BramRausch/PiPod/Case/Assembly/IMG_20180805_153556.jpg

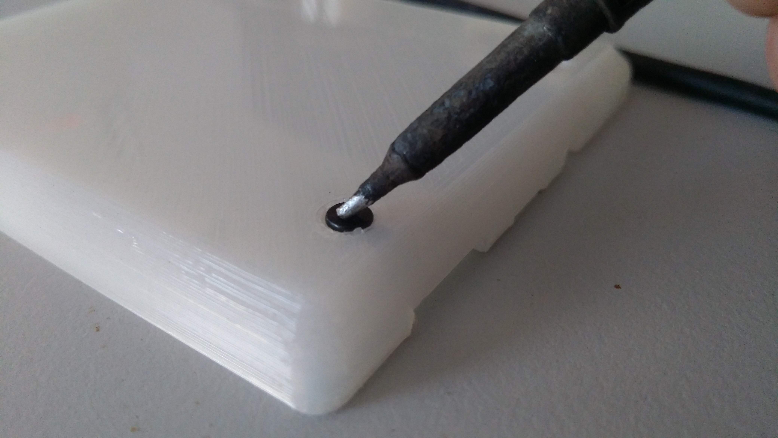
Case/Assembly/IMG_20180805_153556.jpg
