BramRausch/PiPod/Hardware/Assembly/Bottom V2.JPG

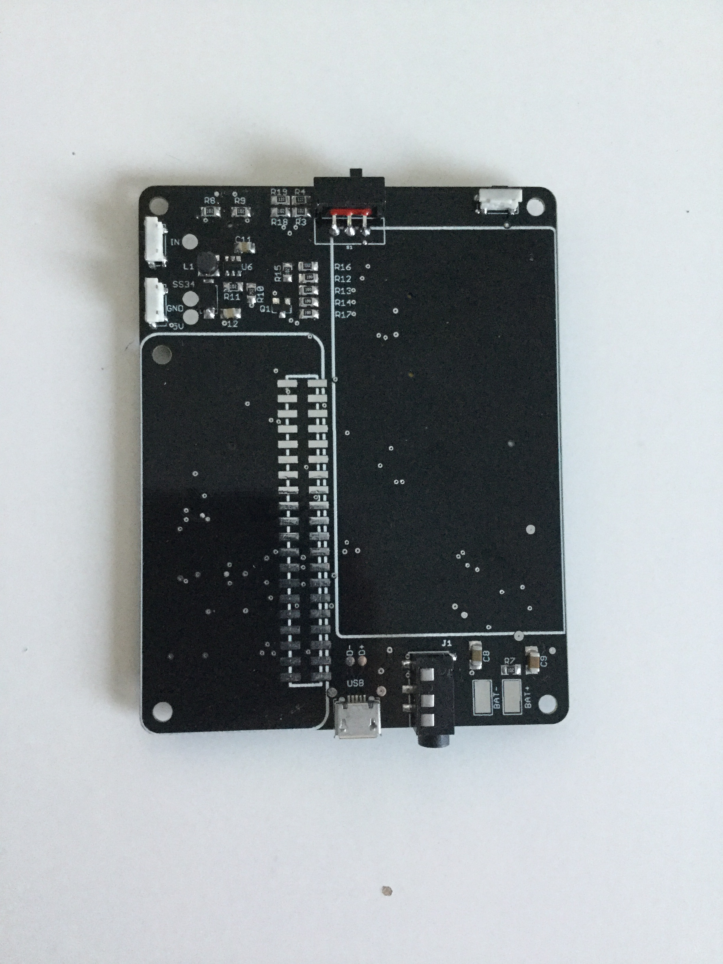
Hardware/Assembly/Bottom V2.JPG
