BramRausch/PiPod/Hardware/Assembly/Part list.xlsx

Name | Value | Package | Quantity
R12, R13, R14, R17 | 10R | 0805 | 4
R7 | 100R | 0805 | 1
R1, R2 | 470R | 0805 | 2
R3, R5, R8, R9, R11, R15, R18 | 1k | 0805 | 7
R4, R6, R19 | 1k2 | 0805 | 3
R10 | 7k5 | 0805 | 1
R16 | 10k | 0805 | 1
RN1 | 10k | 0603-ARC | 1
C13, C14 | 2.2nF | 0805 | 2
C1, C4, C5, C6, C16 | 0.1uF | 0805 | 5
C8, C10 | 0.1uF | 1206 | 2
C7 | 1uF | 0805 | 1
C2, C15 | 2.2uF | 0805 | 2
C3 | 10uF | 0805 | 1
C9 | 10uF | 1206 | 1
C11, C12 | 22uF | 0805 | 2
FB1 | 2500 | 0603 | 1
Q1 | 2N2222 | SOT23 | 1
U1 | DW01 |  | 1
U2 | 8205A |  | 1
U3 | TP4056 |  | 1
U4 | ADS1115 |  | 1
U5 | PCM5102 |  | 1
U6 | MT3608 |  | 1
SS34 | SS34 |  | 1
L1 | CD32 |  | 1
D1, D2 | LED | 0805 | 2
DISP1 |  | TM022HDH26 | 1
USB |  | FCI-10103594-0001LF | 1
J1 |  | PRT-12639 | 1
J2 |  | 2x20 P40 2.54mm SMT Pin Header | 1
S1 |  | EG1218 | 1
I_CENTER, I_LEFT, I_RIGHT, I_UP, I_DOWN |  | TL3342 | 5
I_SLEEP, I_VOL_DOWN, I_VOL_UP |  | TL3330 | 3
 |  |  | 61
