BramRausch/PiPod/Case/Bottom.stl

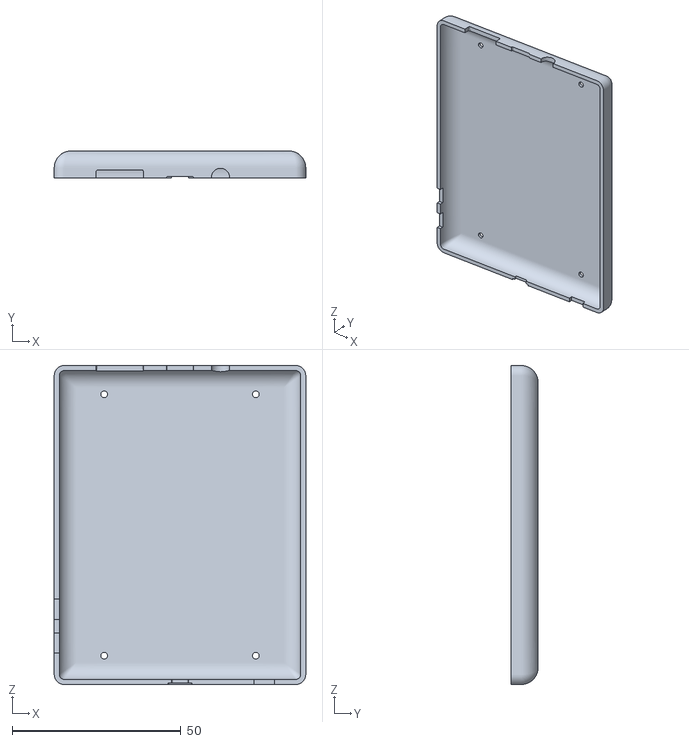
[picture p3: CAD file, 2018-08-07]
Case/Bottom.stl
74.6 x 8.05 x 94.6
