BramRausch/PiPod/Case/Top.stl

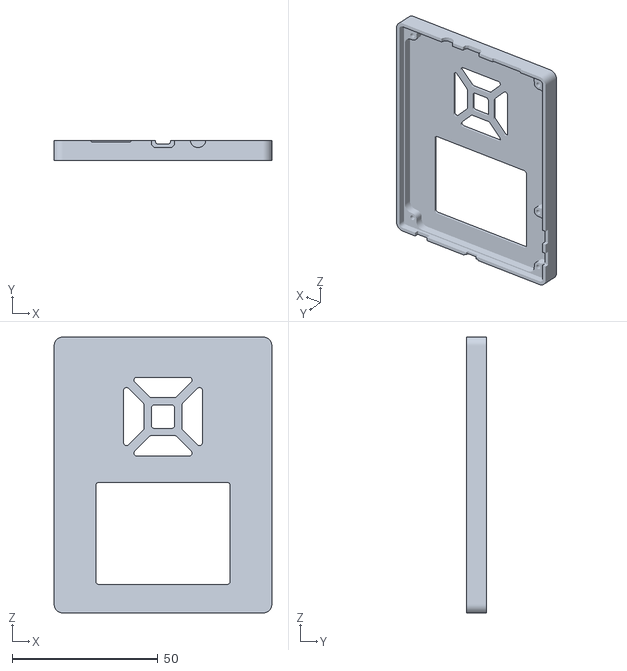
[picture p4: CAD file, 2018-08-07]
Case/Top.stl
74.6 x 7.00 x 94.6
