BramRausch/PiPod/Case/Frame.stl

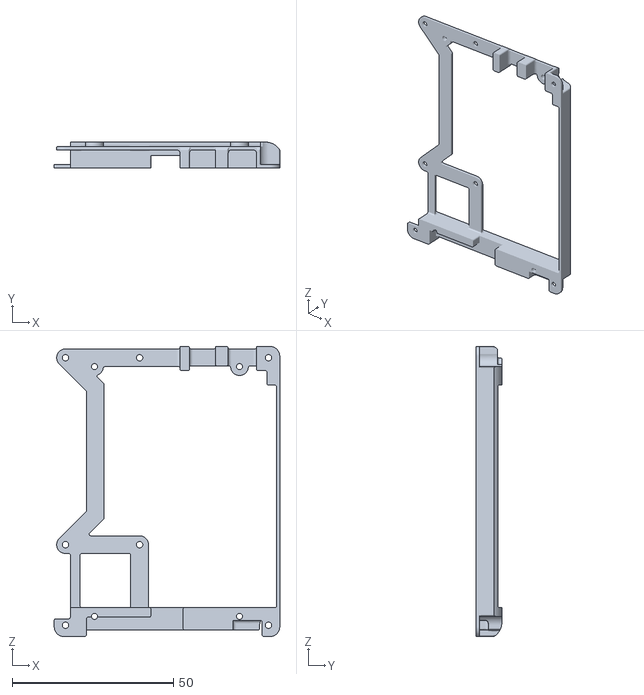
[picture p5: CAD file, 2018-08-07]
Case/Frame.stl
70.0 x 8.00 x 90.0
