BramRausch/PiPod/Case/RPi spacer.stl

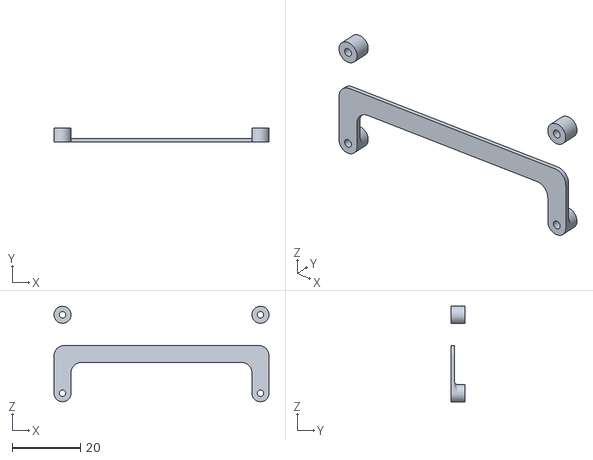
[picture p6: CAD file, 2018-08-07]
Case/RPi spacer.stl
63.0 x 4.00 x 28.0
