BramRausch/PiPod/Case/Buttons (navigation).stl

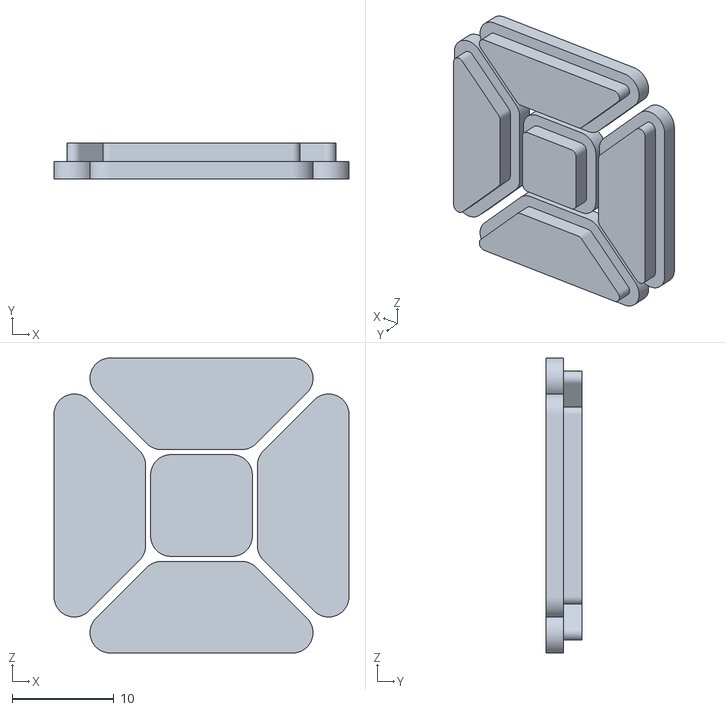
[picture p7: CAD file, 2018-08-07]
Case/Buttons (navigation).stl
29.0 x 3.50 x 29.0
