BramRausch/PiPod/Case/Ring.stl

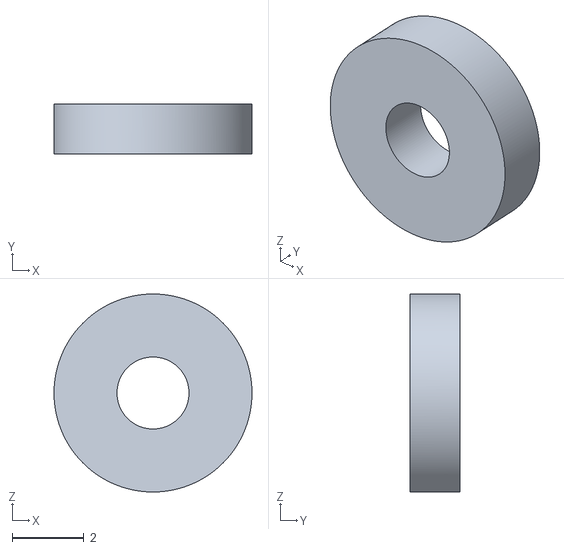
[picture p8: CAD file, 2018-08-07]
Case/Ring.stl
5.50 x 1.40 x 5.50
