BramRausch/PiPod/Case/Button (side).stl

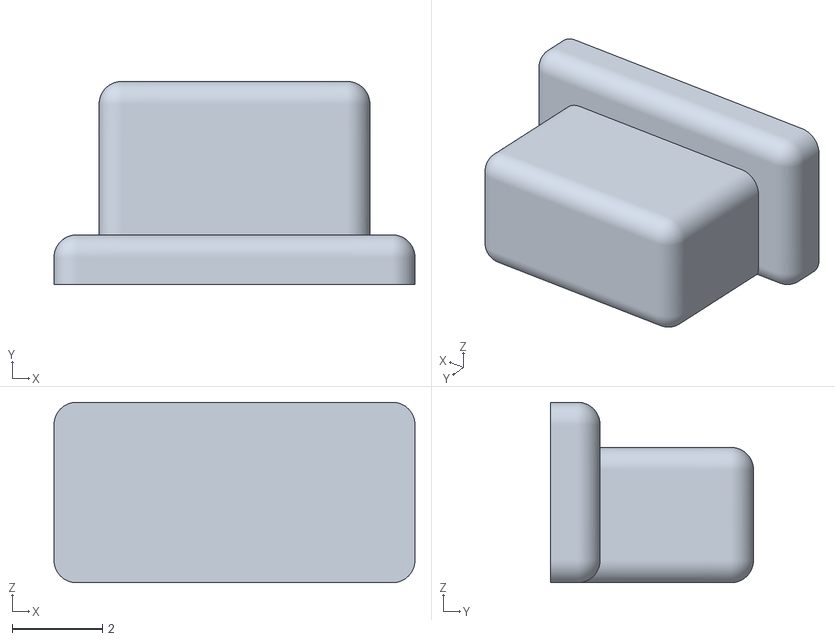
[picture p9: CAD file, 2018-08-07]
Case/Button (side).stl
8.00 x 4.50 x 4.00
