BramRausch/PiPod/Case/Assembly/Step 1 (ISO).png

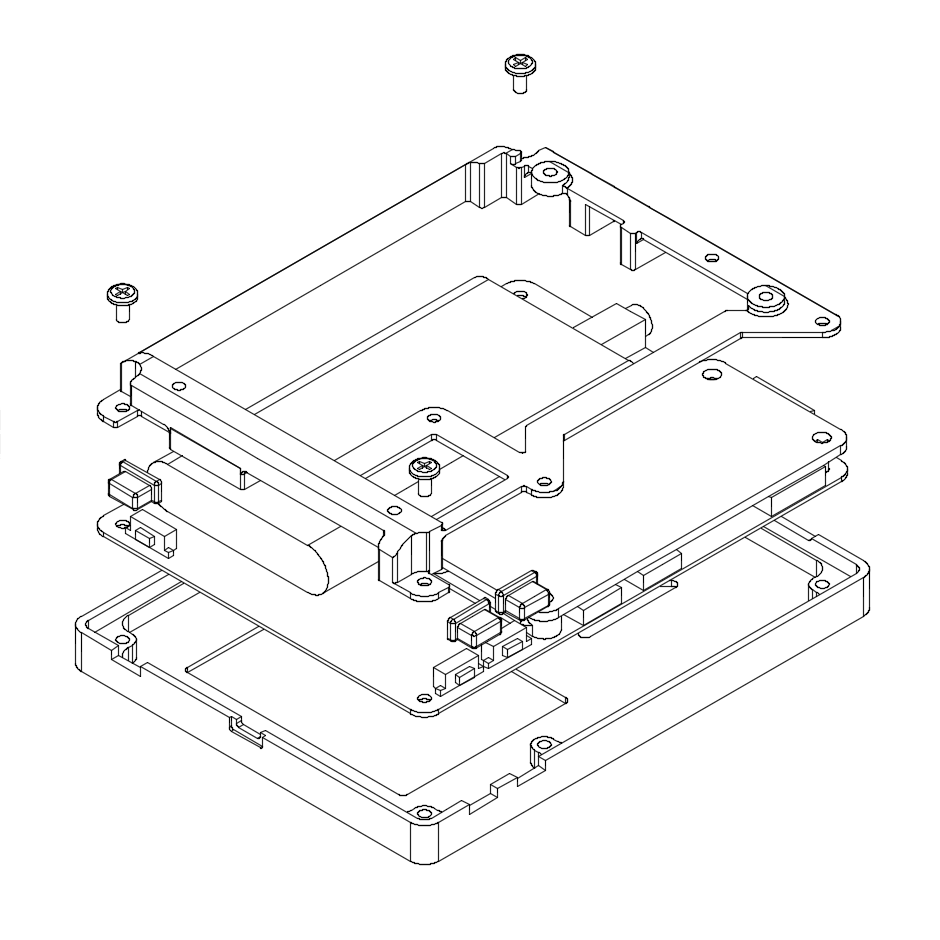
Case/Assembly/Step 1 (ISO).png
