BramRausch/PiPod/Case/Assembly/Step 1.png

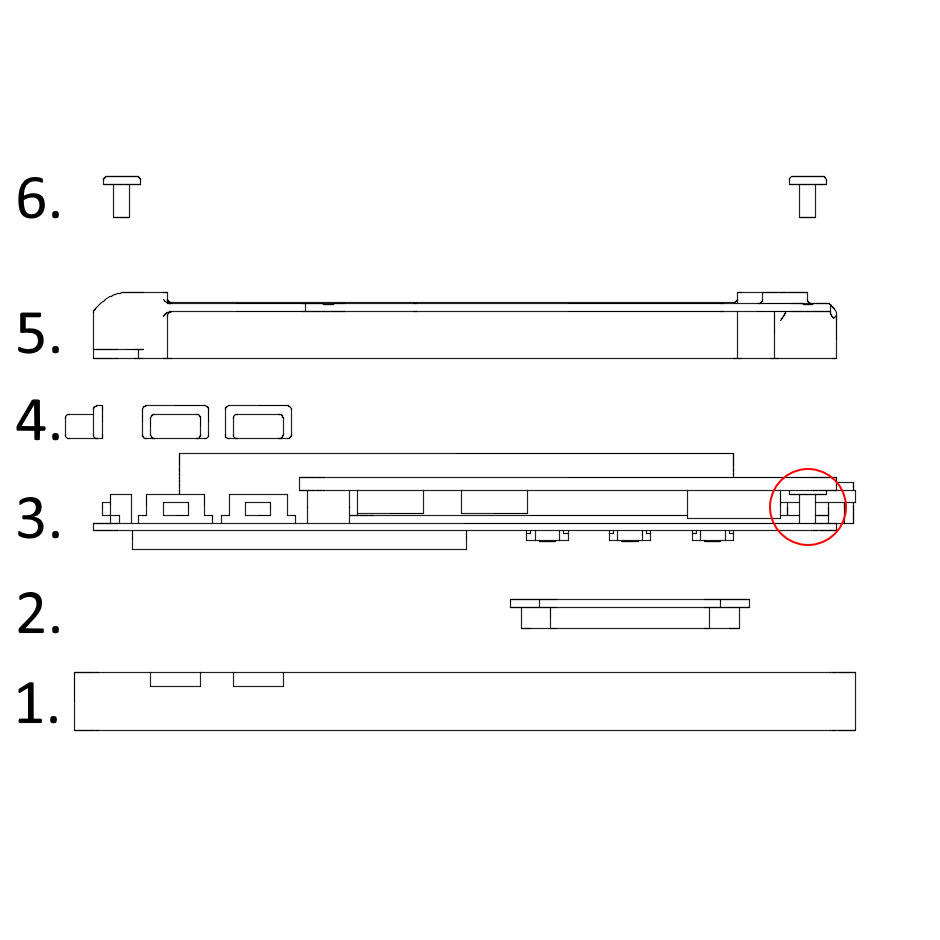
Case/Assembly/Step 1.png
