BramRausch/PiPod/Case/Assembly/Step 2 (Coloured).png

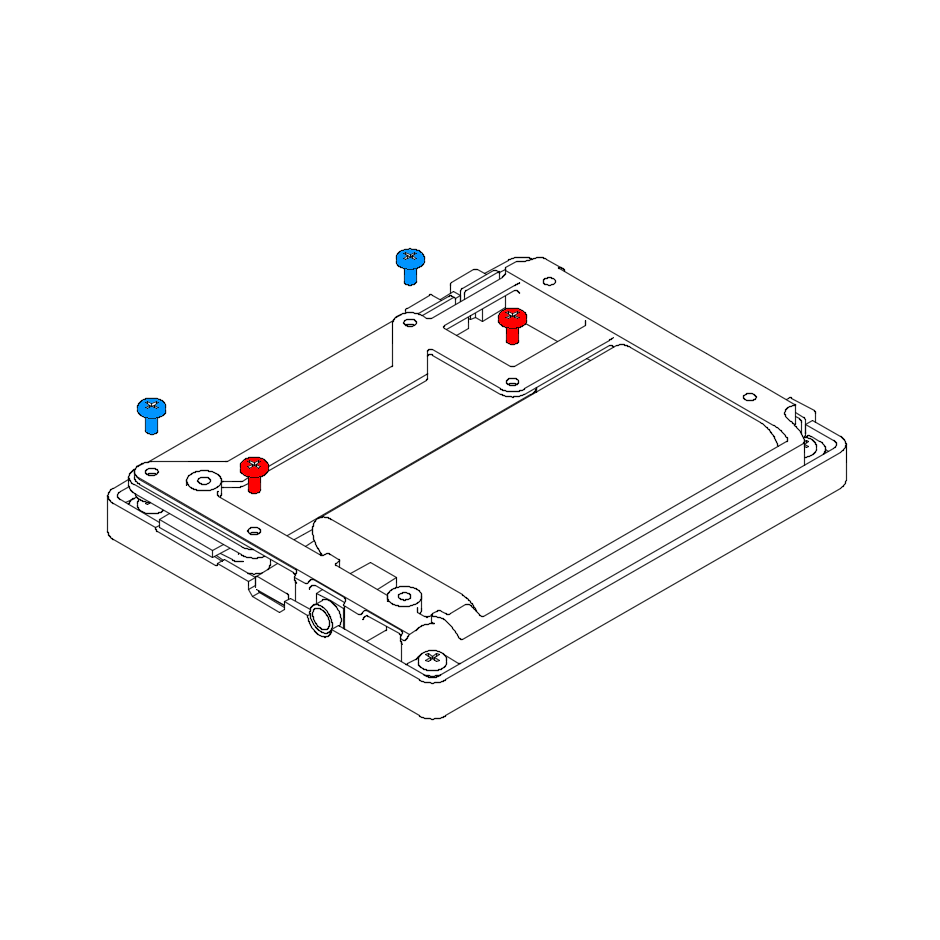
Case/Assembly/Step 2 (Coloured).png
