BramRausch/PiPod/Case/Assembly/Step 3.png

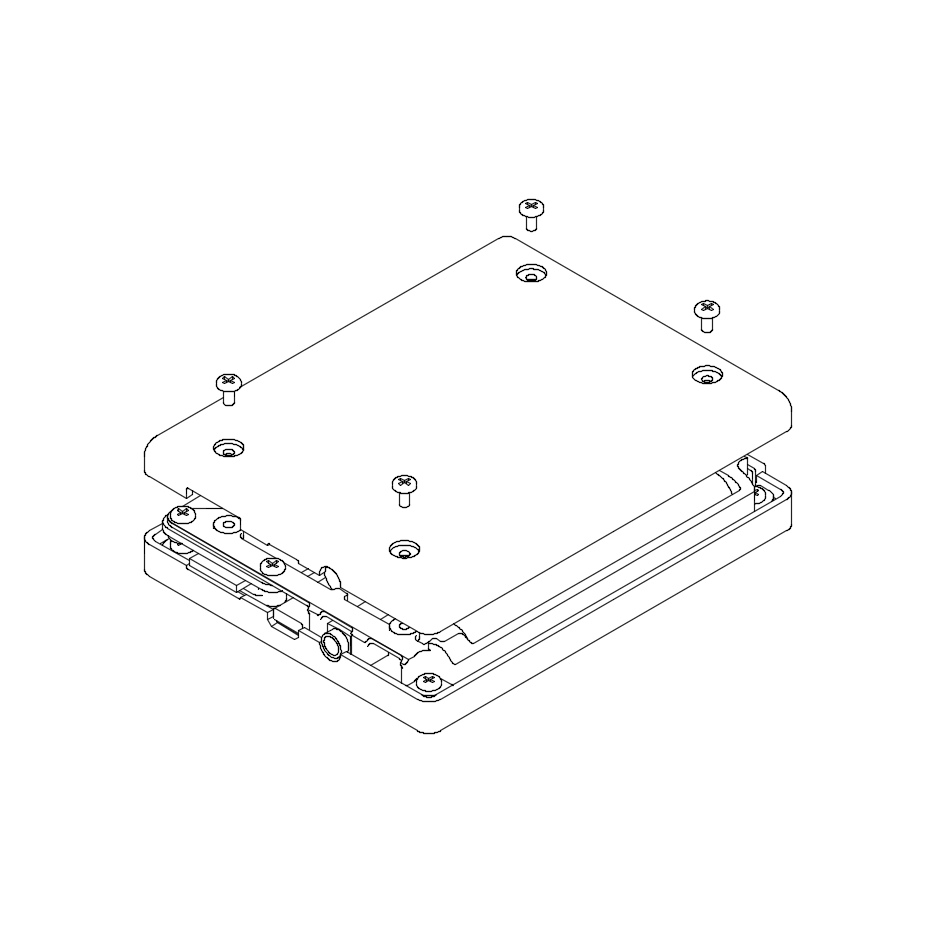
Case/Assembly/Step 3.png
