BramRausch/PiPod/Hardware/Assembly/Bottom V2.png

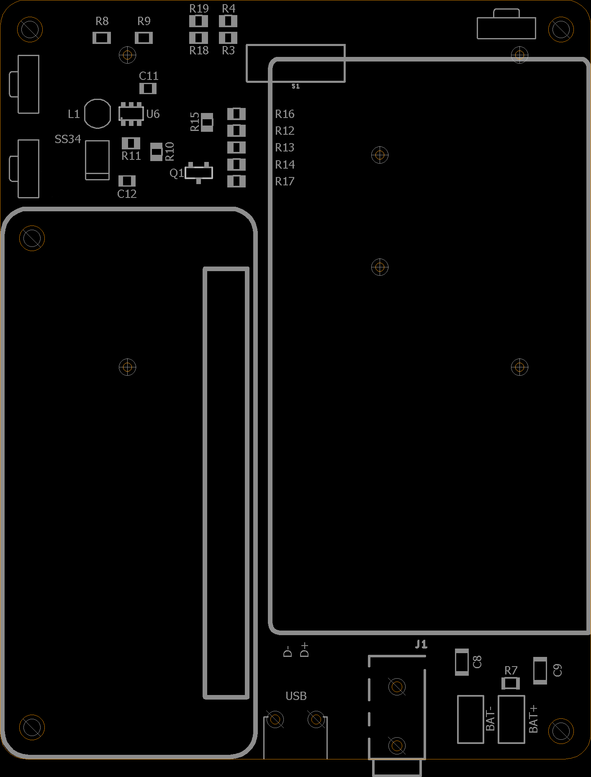
Hardware/Assembly/Bottom V2.png
