BramRausch/PiPod/Hardware/Assembly/Top V2.JPG

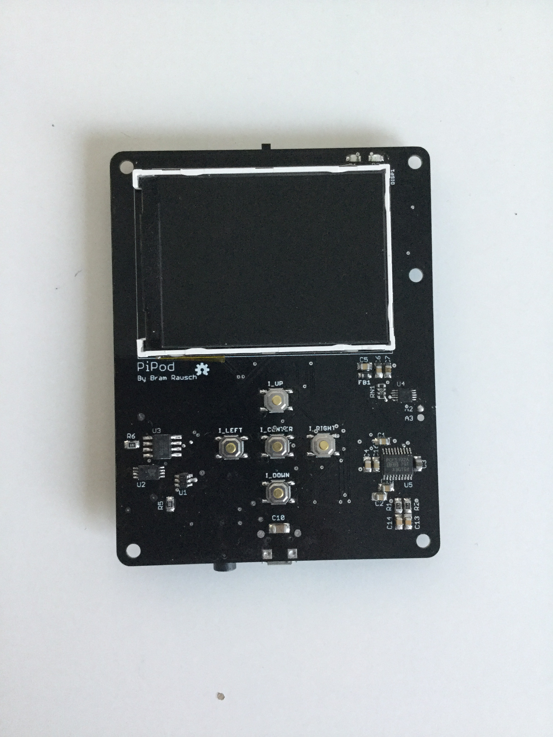
Hardware/Assembly/Top V2.JPG
