BramRausch/PiPod/Hardware/Assembly/Top V2.png

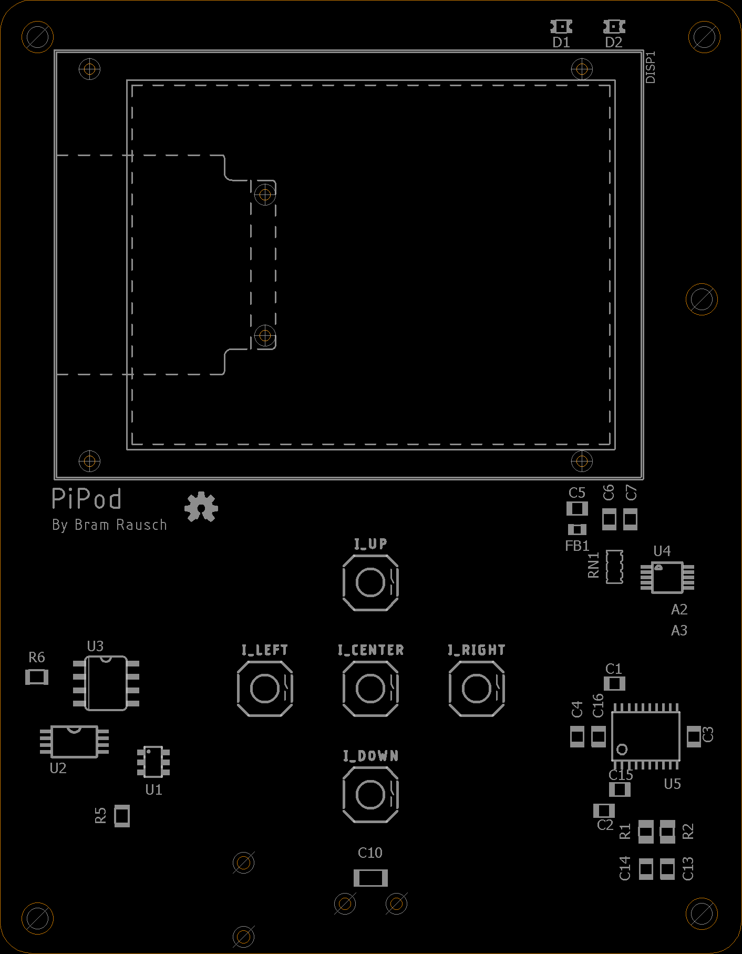
Hardware/Assembly/Top V2.png
