BramRausch/PiPod/(threads)

Thread 1 (2018-08-30):

Awesome project

gearhead, 2018-08-30:
Will be modifying the eagle files and building a version for myself: switching to a PCM5122, add a 48k and 44.1 clock for the PCM5122, add a 3v3 analog supply and add an attiny82 for soft power down capability. I'll provide them if you want to make a V3 version. Looks like there is plenty of room on the PCB. Also, I will be putting RuneAudio on it. Send me a message if you want the eagle files.

Worldgate, 2021-12-02:
Wouldn't happen to know where i can pick up the preassembled board for the v3?  This thing is perfect for an audiobook player i want to make.

ewaca, 2023-06-23:
@Worldgate you can buy assembled board here : https://www.pcbway.com/project/shareproject/PiPod___Raspberry_pi_Zero_portable_music_player.html

Fruity-Grebbles, 2023-06-23:
@gearhead I would appreciate a fork with your modifications

gearhead, 2023-06-24:
Unfortunately, I never finished it. I have a schematic in Eagle, but never finished routing the board. I lost interest after I bought a used iPod Video and put Rockbox on it. I would need to look for the eagle files. let me know if there is still interest and I will see if I can find it.

Thread 2 (2019-10-05):

SSH

thecomfychair2, 2019-10-05:
First up, love this project! My ipod nano finally gave up the ghost and I can't find anything off the shelf to replace it, so this is perfect!
I have flashed your latest image (Google drive link from the Hackaday page) onto my RaPi Zero, but now I can't seem to ssh to it. Does this image still allow for ssh?
I have tried doing the recommended mods to the Boot text files, and creating a file named 'ssh' in the boot directory, but cannot get a rise out of it.
Cheers in advance!

BramRausch, 2019-10-05:
Hey, the latest image doesn't have SSH enabled, and all networking services are disabled to start at the boot process because this isn't necessary for normal function, and speeds up the boot time by 30 - 60 seconds.

I enabled a serial driver instead of the USB ethernet gadget this makes your computer recognize the RPi as a serial device.

you can use a serial console to log in to the RPi using the following information:
Baudrate: 115200
Username: pi
Password: raspberry
The serial port can be found using device-manager.

If you want to use the Wifi functionality you'ill have to enable all network-related services in the system.d configuration.

thecomfychair2, 2019-10-06:
Perfect, that worked! Thank you very much for your help, and quick response!

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

Closed 2019-10-06.

Thread 3 (2023-07-18):

CD32 component résistance value ?

ewaca, 2023-07-18:
@BramRausch This project is amazing !
I'm trying to make this MP3 player, but i wonder wich value of resistance we need for the L1 part (CD32) ?

I tried to check it on your assembled PCB image, but its quality does not allow me to read correctly. It seems to bo write "10" on it.
can you confirm it ?

thank you

JWMTech, 2024-05-02:
I was wondering this myself.

ewaca, 2024-05-04:
it's a 47uh inductance value. I have bought this one and it works fine.
https://www.vs-elec.fr/inductance-cms/8501-inductances-de-puissance-cms-47uh-cd32-smd-353020mm-4uh7-3665662078049.html

But the way it manage the mp3 library is not great. I'm working on a mp3 player projet based on ESP32.

Thread 4 (2023-10-17):

PCB boards

coacharnold1, 2023-10-17:
Hi Bram

    a super cool project.  I'm sorry I missed it when it was new.  I've wanted to do this for  long time.   Can you tell me, are there any PCBs still around to be had, cases?   I'd like to buid one of these.

Thanks

Tim Arnold

JWMTech, 2024-05-02:
I am actively building some on PCB way. If you want one when they come in, I could send you one for a cheap price. They won't be complete, you'll still have to assemble the components on the PCB itself.
