BramRausch/PiPod/Hardware/PiPod Rev2 Schematic.pdf

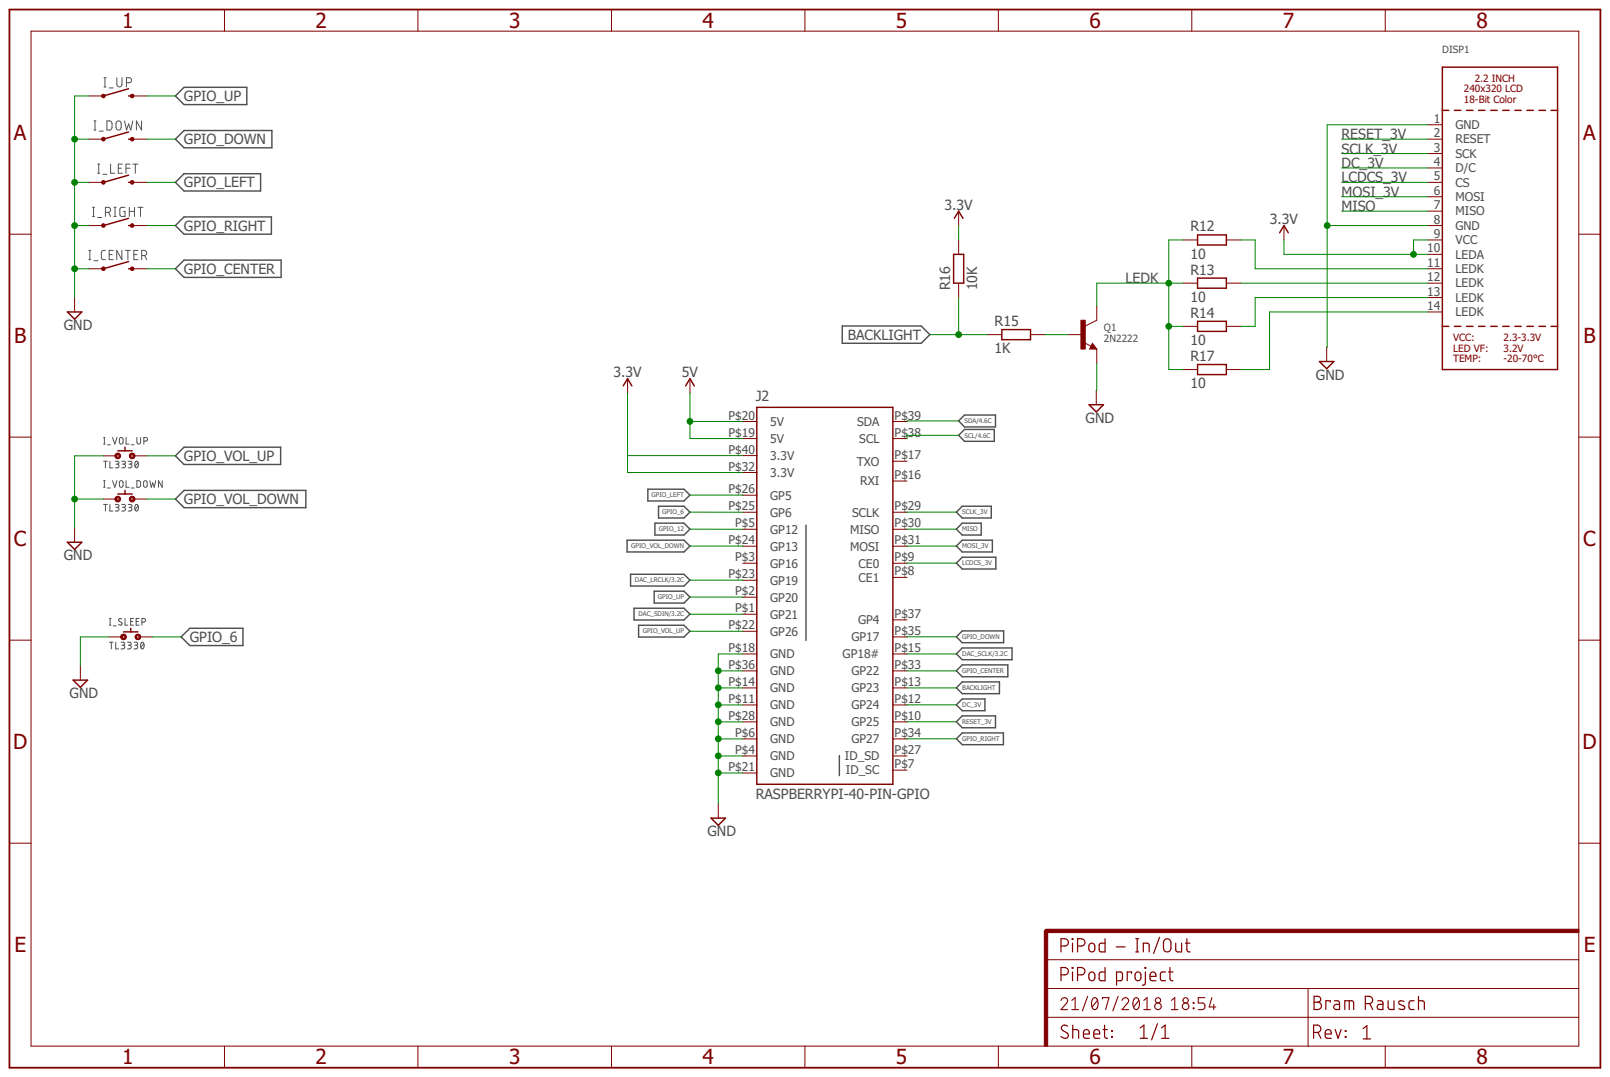
[picture p17: page 1]

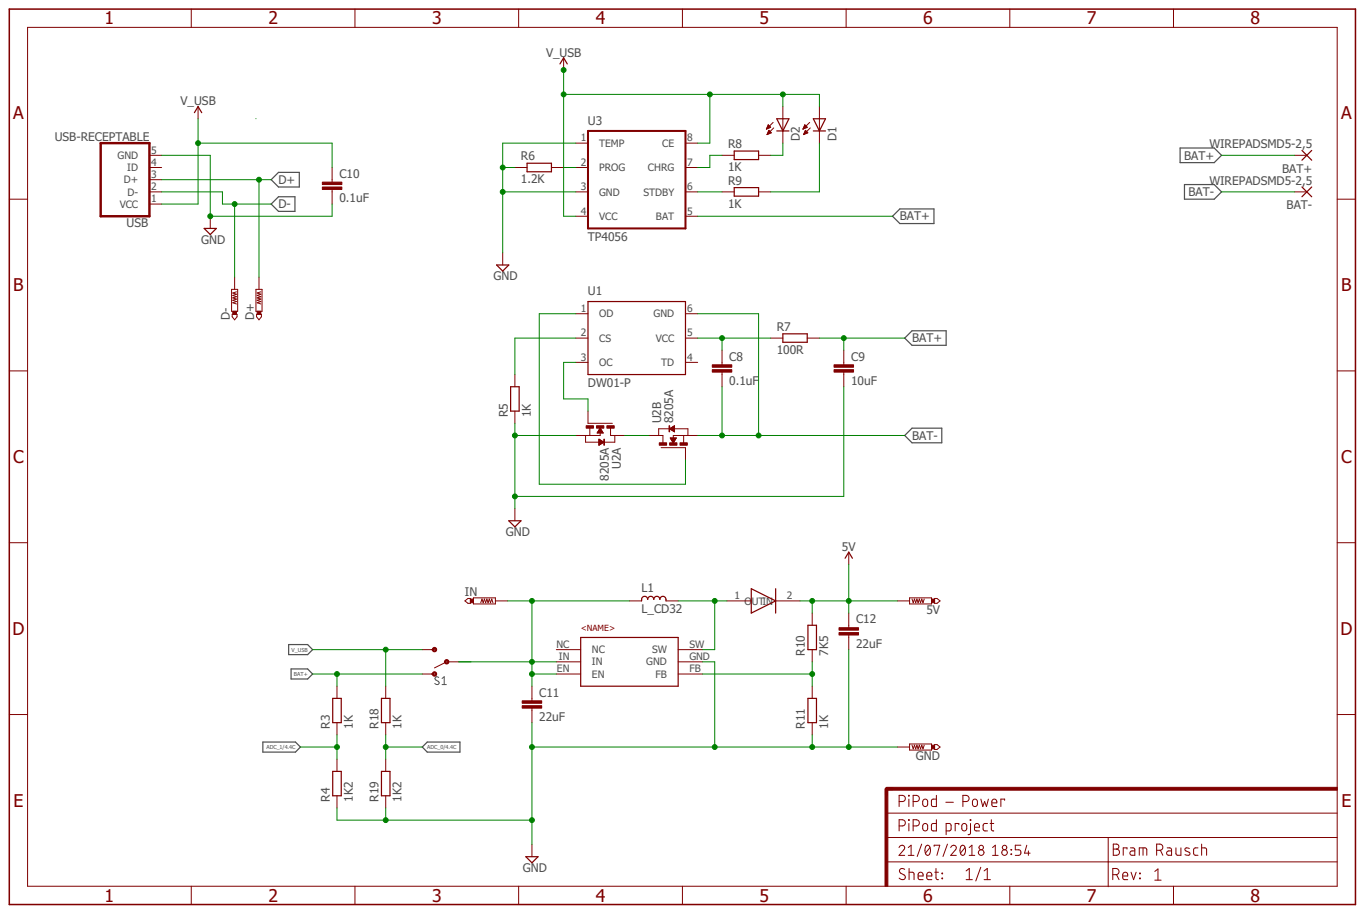
[picture p18: page 2]

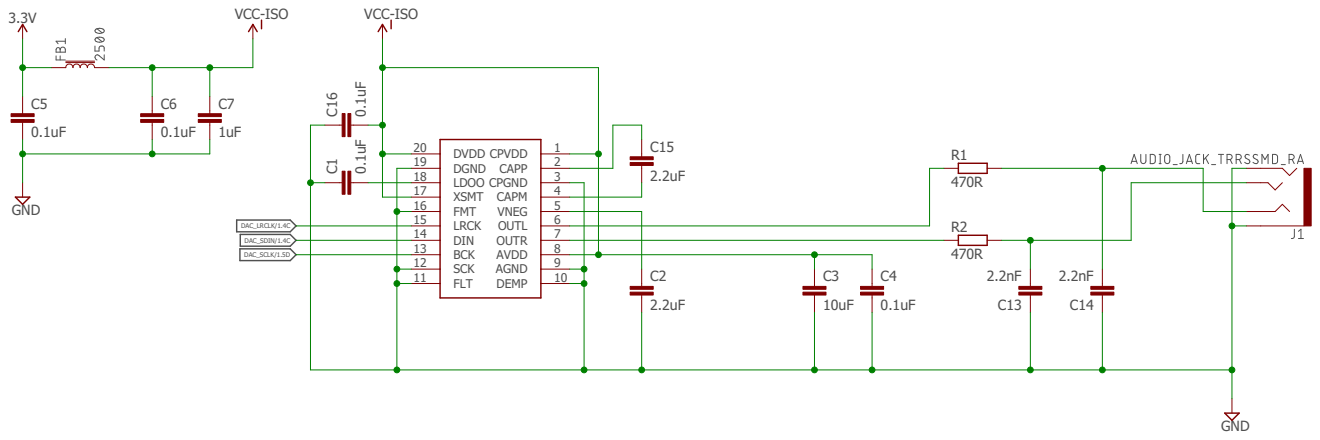
[picture p19: page 3]

17 | 4 VNEG
16 | 5

13 | 8 AGND
12 | 9 DEMP

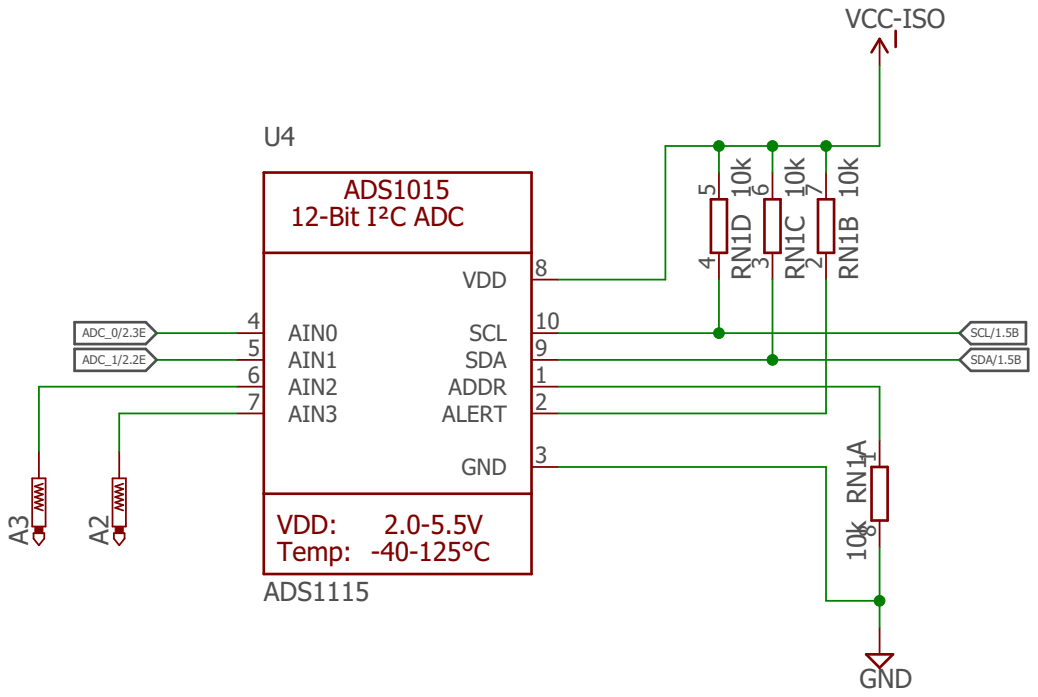
[picture p20: page 4]

10k 10k 10k 10k ADS1115 GND VCC-ISO RN1A1 8 RN1B 2 7 RN1C 3 6 RN1D 4 5 ADDR 1 AIN0 4 AIN1 5 AIN2 6 AIN3 7 ALERT 2 GND 3 SCL 10 SDA 9 VDD 8 U4 A2A3 SCL/1.5B SDA/1.5B ADC_0/2.3E ADC_1/2.2E ABCDE 1 2 3 4 5 6 7 8 ABCDE 1 2 3 4 5 6 7 8 ADS1015 12-Bit I²C ADC VDD: 2.0-5.5V Temp: -40-125°C
