BramRausch/PiPod/Hardware/PiPod Rev3.brd

## EAGLE design Hardware/PiPod Rev3.brd (2019-10-05)

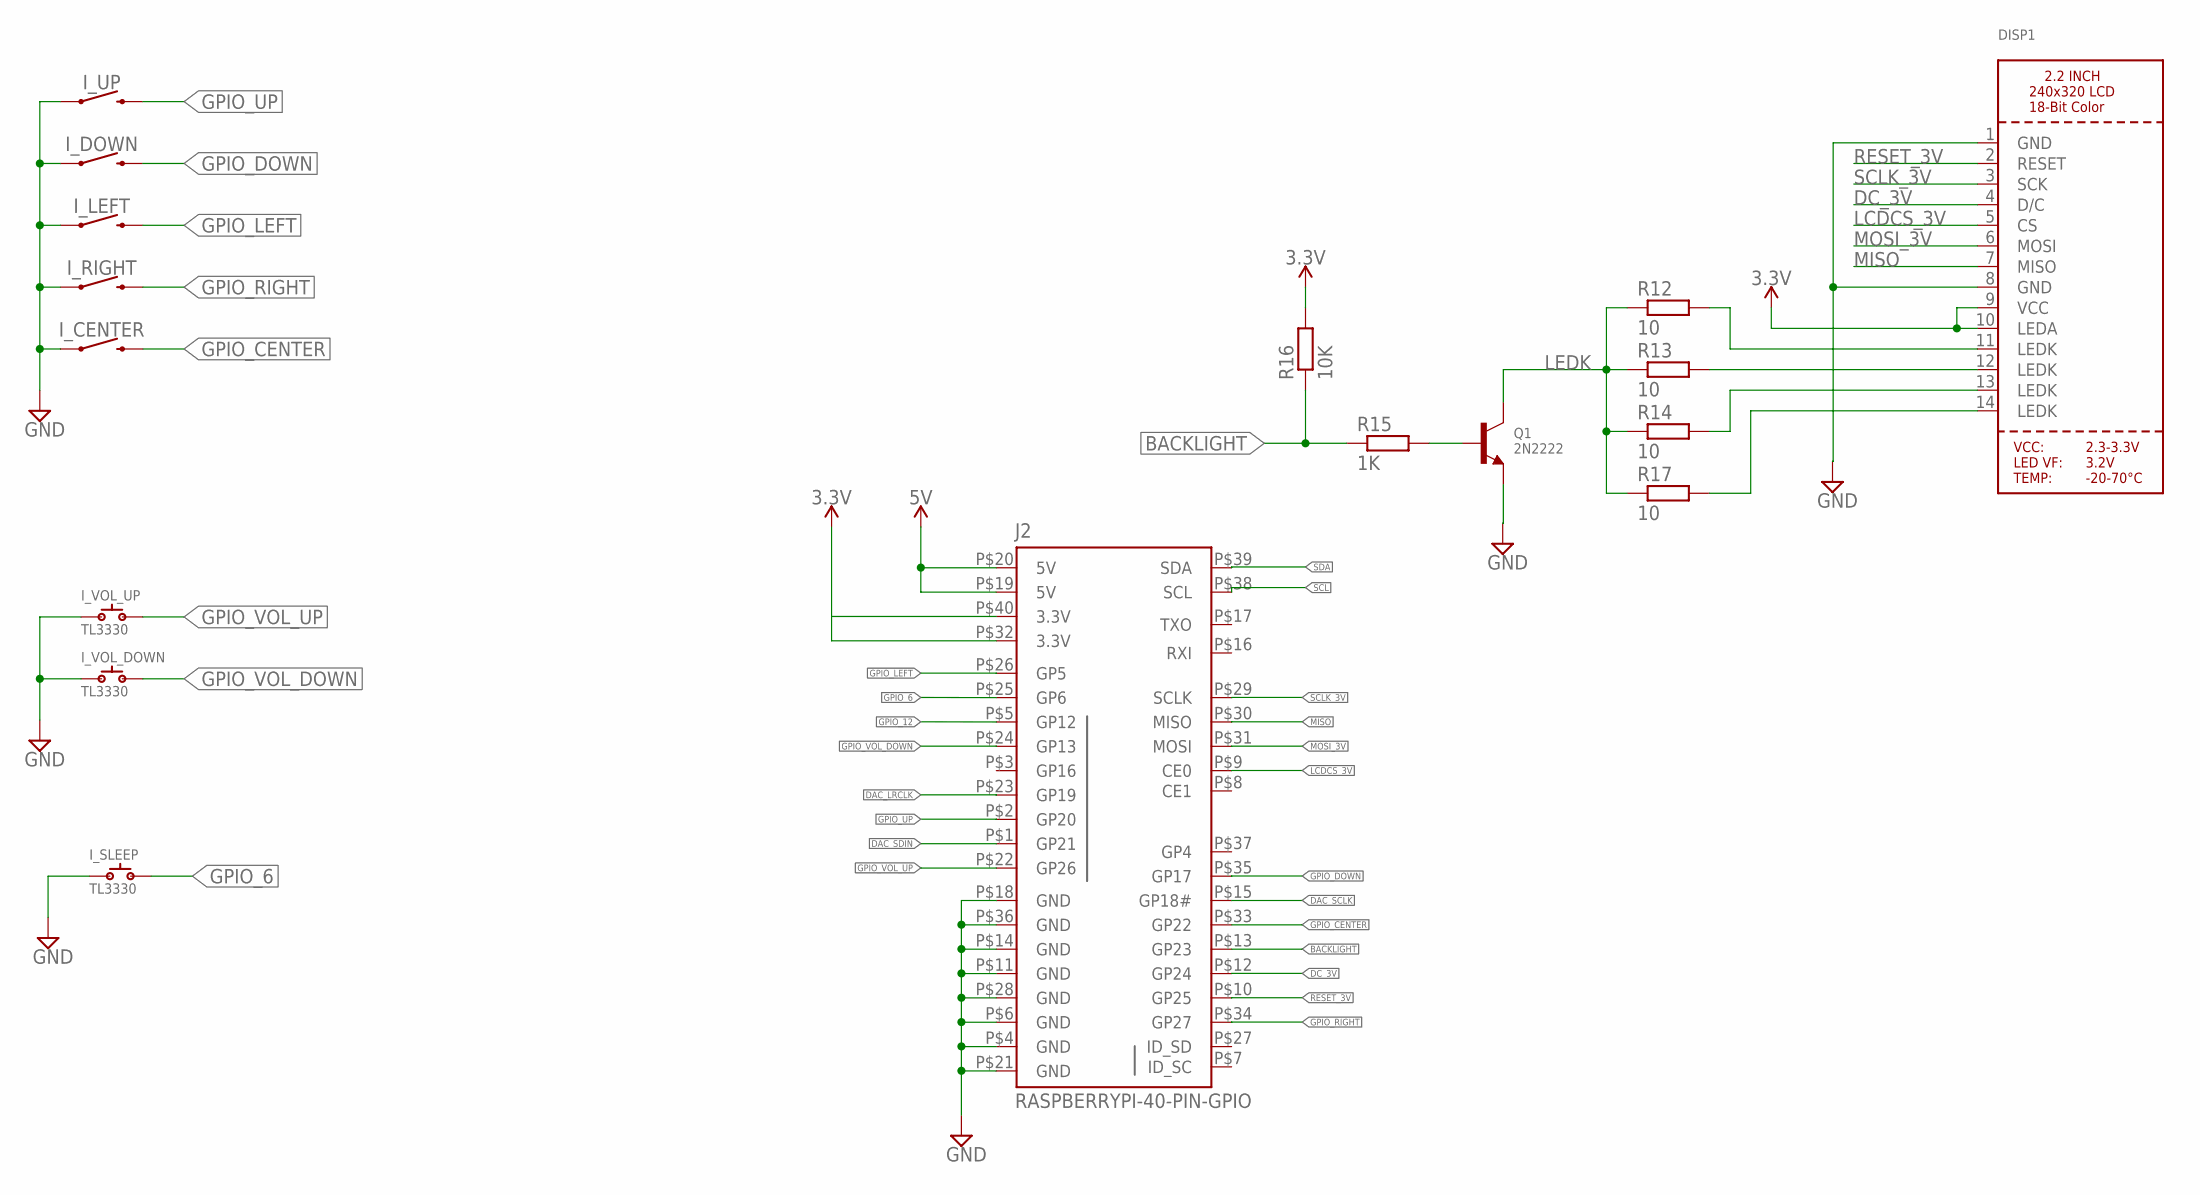
[picture p21: schematic PiPod Rev3.sch, sheet 1]

Parts:
DISP1: DISP_LCD_TM022HDH26; TM022HDH26_2.2IN_LCD
I_CENTER: MOMENTARY-SWITCH-SPST-SMD-5.2-REDUNDANT; TACTILE_SWITCH_SMD_5.2MM
I_DOWN: MOMENTARY-SWITCH-SPST-SMD-5.2-REDUNDANT; TACTILE_SWITCH_SMD_5.2MM
I_LEFT: MOMENTARY-SWITCH-SPST-SMD-5.2-REDUNDANT; TACTILE_SWITCH_SMD_5.2MM
I_RIGHT: MOMENTARY-SWITCH-SPST-SMD-5.2-REDUNDANT; TACTILE_SWITCH_SMD_5.2MM
I_SLEEP: TL3330
I_UP: MOMENTARY-SWITCH-SPST-SMD-5.2-REDUNDANT; TACTILE_SWITCH_SMD_5.2MM
I_VOL_DOWN: TL3330
I_VOL_UP: TL3330
J2: RASPBERRYPI-40-PIN-GPIO; 2X20_SMD
Q1: 2N2222; SOT23-WIDE
R12, R13, R14, R17: 10; R0805
R15: 1K; R0805
R16: 10K; R0805

Connections:
3.3V: DISP1.9 (VCC), DISP1.10 (LEDA), J2.P$32 (3.3V), J2.P$40 (3.3V), R16.2; also elsewhere on the board
5V: J2.P$19 (5V), J2.P$20 (5V); also elsewhere on the board
BACKLIGHT: J2.P$13 (GP23), R15.1, R16.1
DAC_LRCLK: J2.P$23 (GP19); also elsewhere on the board
DAC_SCLK: J2.P$15 (GP18#); also elsewhere on the board
DAC_SDIN: J2.P$1 (GP21); also elsewhere on the board
DC_3V: DISP1.4 (D/C), J2.P$12 (GP24)
GND: DISP1.1 (GND), DISP1.8 (GND), I_CENTER.1, I_CENTER.2 (1), I_DOWN.1, I_DOWN.2 (1), I_LEFT.1, I_LEFT.2 (1), I_RIGHT.1, I_RIGHT.2 (1), I_SLEEP.1, I_UP.1, I_UP.2 (1), I_VOL_DOWN.1, I_VOL_UP.1, J2.P$4 (GND), J2.P$6 (GND), J2.P$11 (GND), J2.P$14 (GND), J2.P$18 (GND), J2.P$21 (GND), J2.P$28 (GND), J2.P$36 (GND), Q1.2 (E); also elsewhere on the board
GPIO_6: I_SLEEP.2, J2.P$25 (GP6)
GPIO_12: J2.P$5 (GP12)
GPIO_CENTER: I_CENTER.3 (2), I_CENTER.4 (2), J2.P$33 (GP22)
GPIO_DOWN: I_DOWN.3 (2), I_DOWN.4 (2), J2.P$35 (GP17)
GPIO_LEFT: I_LEFT.3 (2), I_LEFT.4 (2), J2.P$26 (GP5)
GPIO_RIGHT: I_RIGHT.3 (2), I_RIGHT.4 (2), J2.P$34 (GP27)
GPIO_UP: I_UP.3 (2), I_UP.4 (2), J2.P$2 (GP20)
GPIO_VOL_DOWN: I_VOL_DOWN.2, J2.P$24 (GP13)
GPIO_VOL_UP: I_VOL_UP.2, J2.P$22 (GP26)
LCDCS_3V: DISP1.5 (CS), J2.P$9 (CE0)
LEDK: Q1.3 (C), R12.1, R13.1, R14.1, R17.1
MISO: DISP1.7 (MISO), J2.P$30 (MISO)
MOSI_3V: DISP1.6 (MOSI), J2.P$31 (MOSI)
unnamed: DISP1.11 (LEDK), R12.2
unnamed: DISP1.12 (LEDK), R13.2
unnamed: DISP1.13 (LEDK), R14.2
unnamed: Q1.1 (B), R15.2
unnamed: DISP1.14 (LEDK), R17.2
RESET_3V: DISP1.2 (RESET), J2.P$10 (GP25)
SCL: J2.P$38 (SCL); also elsewhere on the board
SCLK_3V: DISP1.3 (SCK), J2.P$29 (SCLK)
SDA: J2.P$39 (SDA); also elsewhere on the board

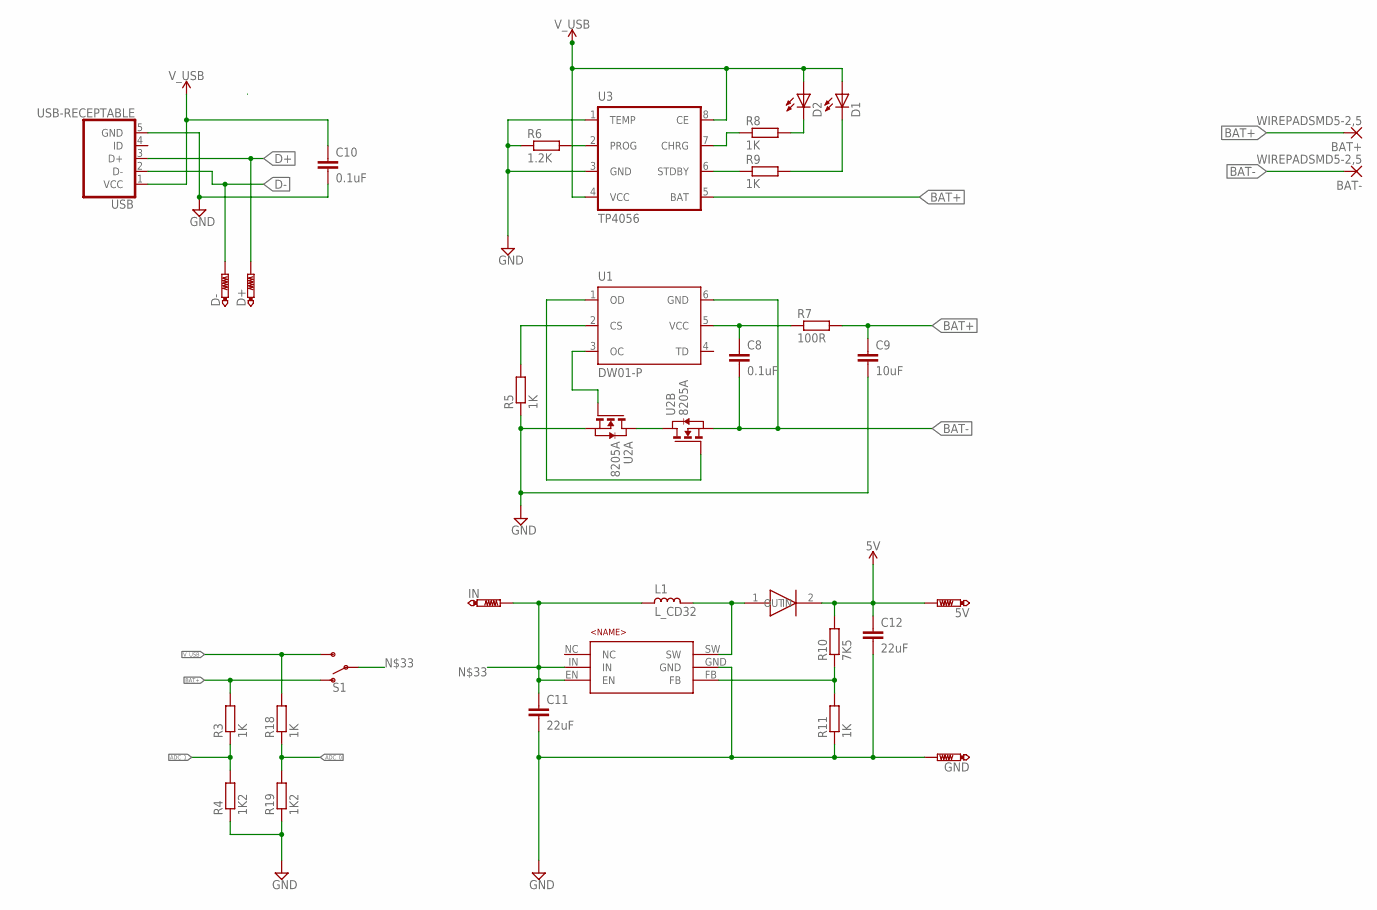
[picture p22: schematic PiPod Rev3.sch, sheet 2]

Parts:
5V: PTR1B2,54; B2,54
BAT+: WIREPADSMD5-2,5; 5-2,5
BAT-: WIREPADSMD5-2,5; 5-2,5
C8, C10: 0.1uF; C1206K
C9: 10uF; C1206K
C11, C12: 22uF; C0805K
D1, D2: LEDCHIPLED_0805; CHIPLED_0805
D+: PTR1TP15R; TP15R
D-: PTR1TP15R; TP15R
GND: PTR1B2,54; B2,54
IN: PTR1B2,54; B2,54
L1: L_CD32; CD32
R3, R11, R18: 1K; R0805
R4, R19: 1K2; R0805
R5, R8, R9: 1K; M0805
R6: 1.2K; M0805
R7: 100R; M0805
R10: 7K5; R0805
S1: SWITCH-SPDT-PTH-11.6X4.0MM; SWITCH_SPDT_PTH_11.6X4.0MM
U1: DW01-P; SOT23-6L
U2: 8205A; TSSOP8
U3: TP4056; SO08
U6: MT3608; SOT23-6
U$9: SMA-SS34
USB: USB-RECEPTABLE; FCI-10103594-0001LF

Connections:
5V: 5V.TP, C12.1, R10.2, U$9.2 (OUT); also elsewhere on the board
ADC_0: R18.1, R19.2; also elsewhere on the board
ADC_1: R3.1, R4.2; also elsewhere on the board
BAT+: BAT+.1, C9.1, R3.2, R7.2, S1.1 (O), U3.5 (BAT)
BAT-: BAT-.1, C8.2, U1.6 (GND), U2.6 (S), U2.7 (S)
D+: D+.TP, USB.3 (D+)
D-: D-.TP, USB.2 (D-)
GND: C9.2, C10.2, C11.2, C12.2, GND.TP, R4.1, R5.1, R6.1, R11.1, R19.1, U2.2 (S), U2.3 (S), U3.1 (TEMP), U3.3 (GND), U6.GND, USB.5 (GND); also elsewhere on the board
unnamed: U2.1 (D), U2.8 (D)
unnamed: U1.1 (OD), U2.5 (G)
unnamed: R5.2, U1.2 (CS)
unnamed: R6.2, U3.2 (PROG)
unnamed: U1.3 (OC), U2.4 (G)
unnamed: R9.1, U3.6 (STDBY)
unnamed: C8.1, R7.1, U1.5 (VCC)
unnamed: D2.C, R8.2
unnamed: D1.C, R9.2
unnamed: R8.1, U3.7 (CHRG)
unnamed: L1.1, U6.SW, U$9.1 (IN)
unnamed: R10.1, R11.2, U6.FB
unnamed: C11.1, IN.TP, L1.2, S1.2, U6.EN, U6.IN
V_USB: C10.1, D1.A, D2.A, R18.2, S1.3 (S), U3.4 (VCC), U3.8 (CE), USB.1 (VCC)

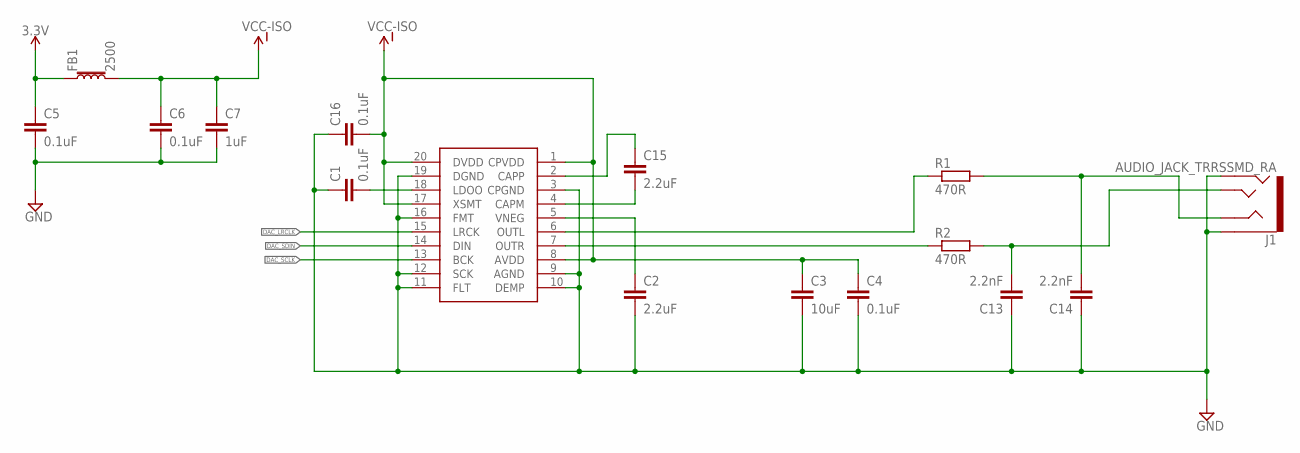
[picture p23: schematic PiPod Rev3.sch, sheet 3]

Parts:
C1, C4, C5, C6, C16: 0.1uF; C0805K
C2, C15: 2.2uF; C0805K
C3: 10uF; C0805K
C7: 1uF; C0805K
C13, C14: 2.2nF; C0805K
FB1: 2500; 0603
J1: AUDIO_JACK_TRRSSMD_RA; AUDIO_JACK_3.5MM_TRRS_SMD_RA
R1, R2: 470R; R0805
U5: PCM5102; TSSOP20

Connections:
3.3V: C5.1, FB1.1; also elsewhere on the board
DAC_LRCLK: U5.15 (LRCK); also elsewhere on the board
DAC_SCLK: U5.13 (BCK); also elsewhere on the board
DAC_SDIN: U5.14 (DIN); also elsewhere on the board
GND: C1.1, C2.2, C3.2, C4.2, C5.2, C6.2, C7.2, C13.1, C14.1, C16.1, J1.EARTH, J1.RING2, U5.3 (CPGND), U5.9 (AGND), U5.10 (DEMP), U5.11 (FLT), U5.12 (SCK), U5.16 (FMT), U5.19 (DGND); also elsewhere on the board
unnamed: C1.2, U5.18 (LDOO)
unnamed: C2.1, U5.5 (VNEG)
unnamed: C15.2, U5.4 (CAPM)
unnamed: R2.1, U5.7 (OUTR)
unnamed: R1.1, U5.6 (OUTL)
unnamed: C15.1, U5.2 (CAPP)
unnamed: C13.2, J1.TIP, R2.2
unnamed: C14.2, J1.RING1, R1.2
VCC-ISO: C3.1, C4.1, C6.1, C7.1, C16.2, FB1.2, U5.1 (CPVDD), U5.8 (AVDD), U5.17 (XSMT), U5.20 (DVDD); also elsewhere on the board

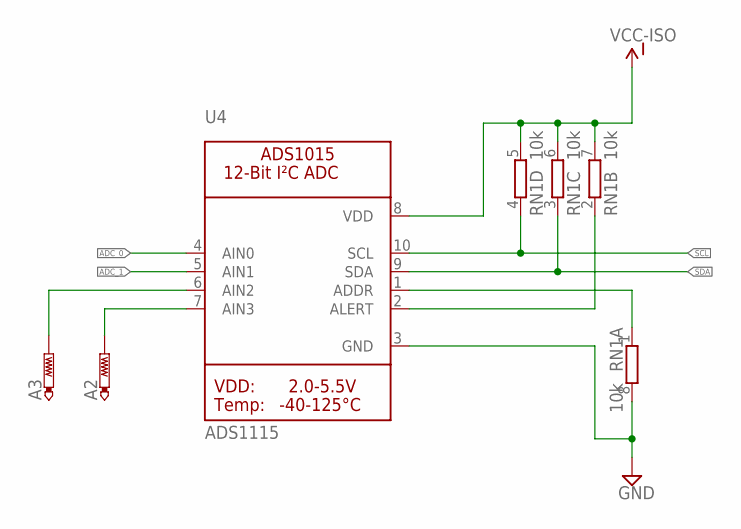
[picture p24: schematic PiPod Rev3.sch, sheet 4]

Parts:
A2, A3: PTR1TP15R; TP15R
RN1: 10k; 0603-ARC
U4: ADS1115; MICROBUILDER_MSOP10

Connections:
ADC_0: U4.4 (AIN0); also elsewhere on the board
ADC_1: U4.5 (AIN1); also elsewhere on the board
GND: RN1.8 (2), U4.3 (GND); also elsewhere on the board
unnamed: A2.TP, U4.7 (AIN3)
unnamed: RN1.1, U4.1 (ADDR)
unnamed: RN1.2 (1), U4.2 (ALERT)
unnamed: A3.TP, U4.6 (AIN2)
SCL: RN1.4 (1), U4.10 (SCL); also elsewhere on the board
SDA: RN1.3 (1), U4.9 (SDA); also elsewhere on the board
VCC-ISO: RN1.5 (2), RN1.6 (2), RN1.7 (2), U4.8 (VDD); also elsewhere on the board

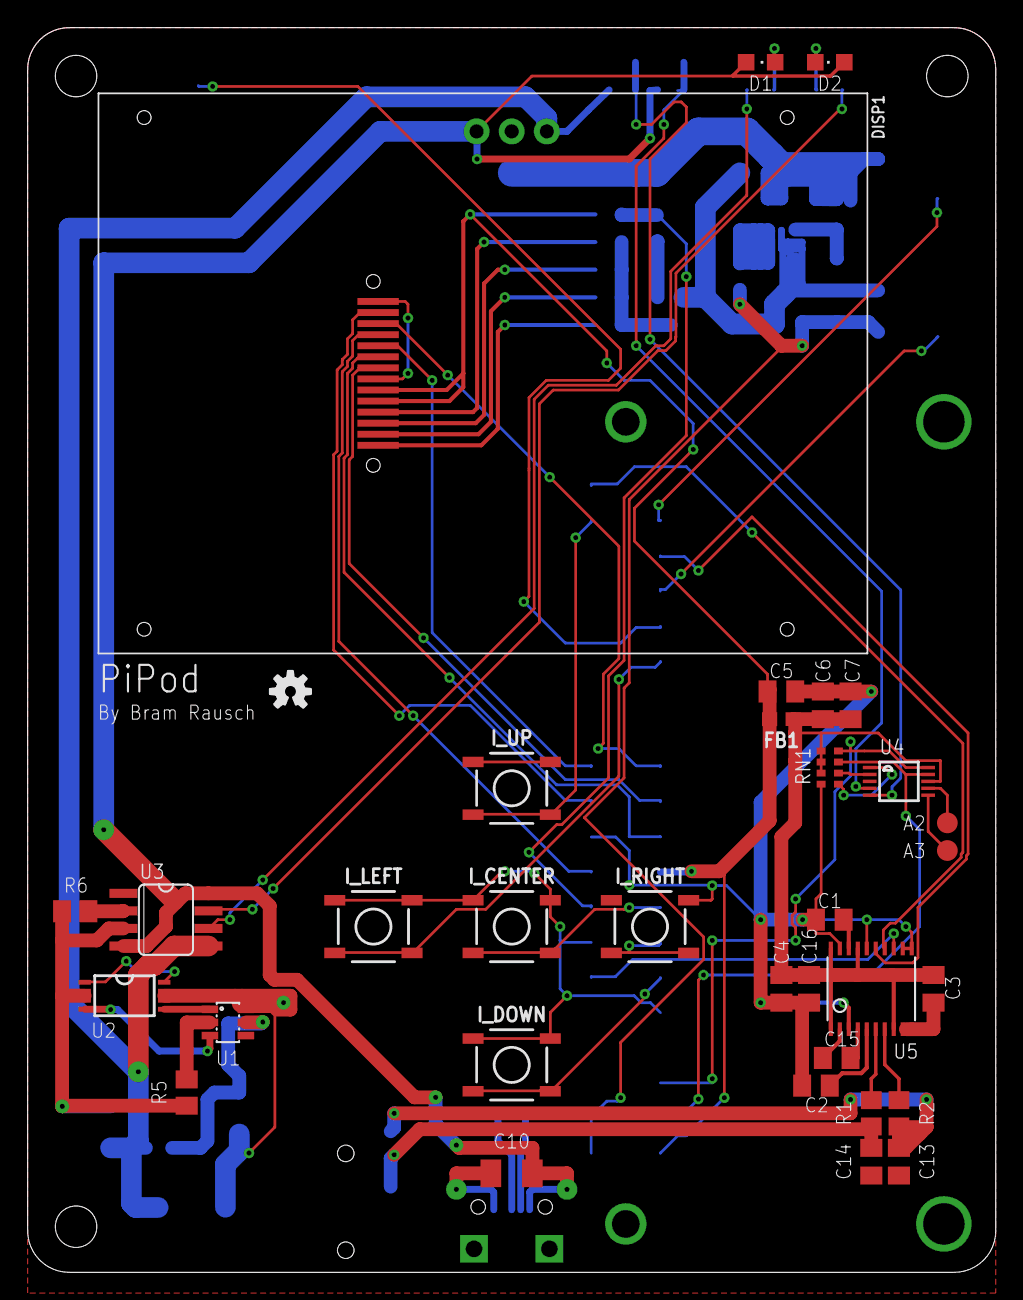
[picture p25: board PiPod Rev3.brd from above]

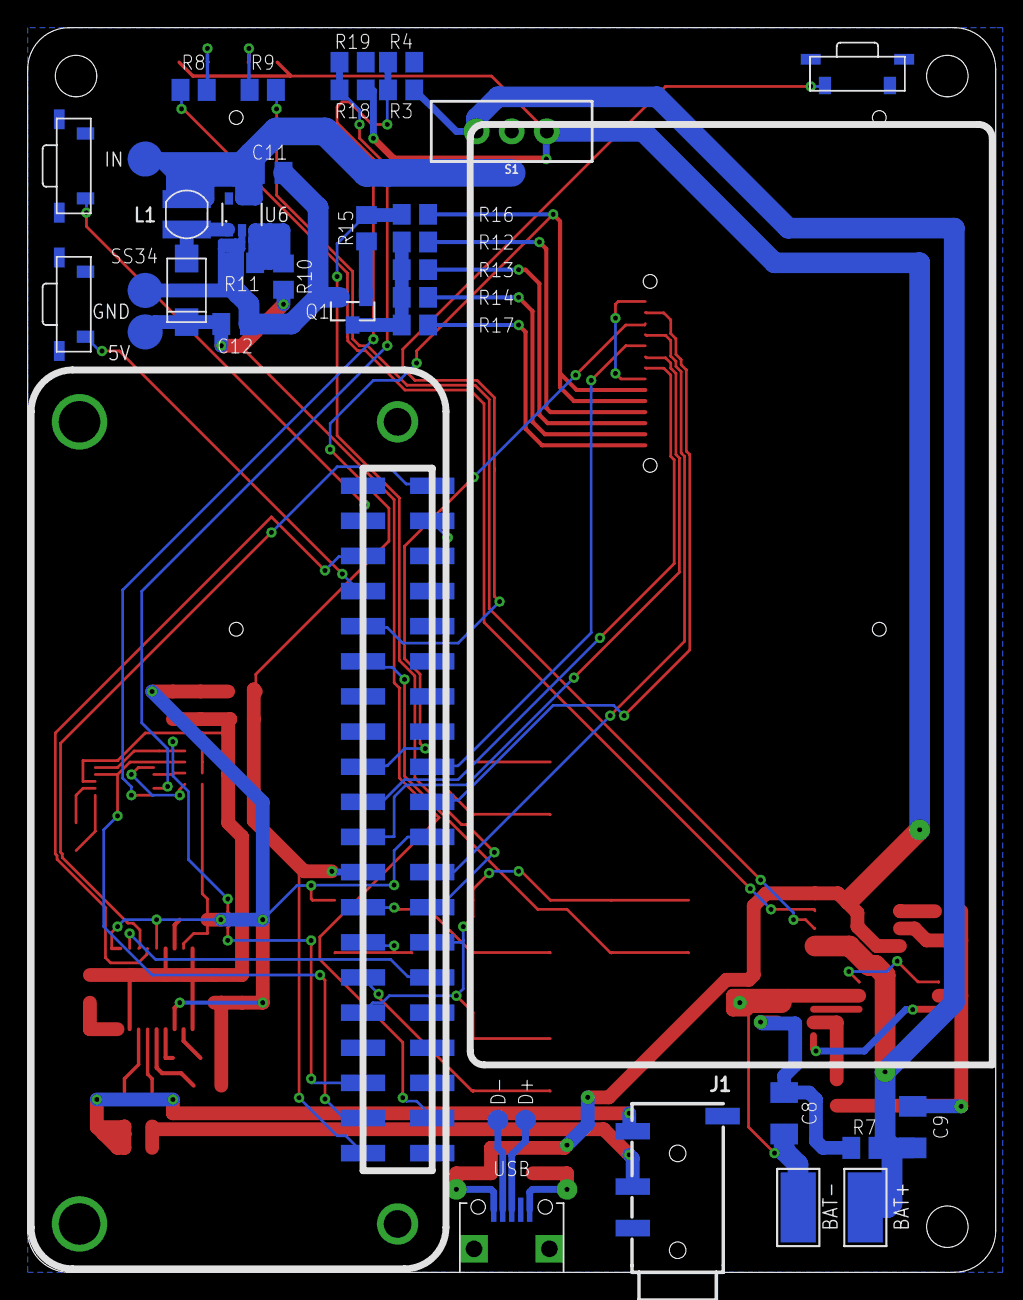
[picture p26: board PiPod Rev3.brd from below]

Board: 2 copper layers, 70.0 x 90.0 mm, 71 parts (37 on the bottom side), 62 nets.

Other parts of the board:
E$1: OSHW-LOGO-S
