BramRausch/PiPod/(commit log)

2018-08-02 Final version assembly
    [Part list.xlsx, PiPod Rev2 BOM.csv, PiPod Rev2 Partlist.csv]
2018-08-07 3D files and assembly instruction images from the case
    [Bottom.stl, Button (side).stl, Buttons (navigation).stl, Frame.stl, RPi spacer.stl, Ring.stl, Top.stl]
2018-08-16 V1.0 release
    Release V1.0:
    * Current supported filetypes:
    .mp3, .m4a, .wav, .wma
    * New program structure
    * Replaced pygame mixer with VLC player
    * Replaced Eye3d with tagLib
    [info.csv]
